bpereira615/AutonomousResponders/(commit log)

2017-04-25 Modularized tests and IMU calibration
2017-04-28 Corrected forward method and sped up forward motors
    [Ambulance.ino]
2017-04-28 Prepared spool and base motors for code, to be tested
2017-04-30 improves crane seeking, adds crane location diy pwm
2017-05-02 changes pixy communication to use I2C instead of SPI
2017-05-05 Fixed everything, shit now works(knock on wood)
    [Crane.ino]
2017-05-09 Mini-Challenge 2 Update
    Ambulance.ino - prepared for XBee communication
    Crane.ino - changed for loops to while, weird bug fixed
    [Ambulance.ino, Crane.ino]
2017-05-11 Calibration updates
    Ambulance.ino - tweaked distances for exiting city, waits at bottom crane
    Crane.ino - calibrated for new spool design
2017-05-12 Edits to crane control flow to improve reliability
